promavto/Pressure_meter/DOC/ВПВ.pdf

A (2 : 1)

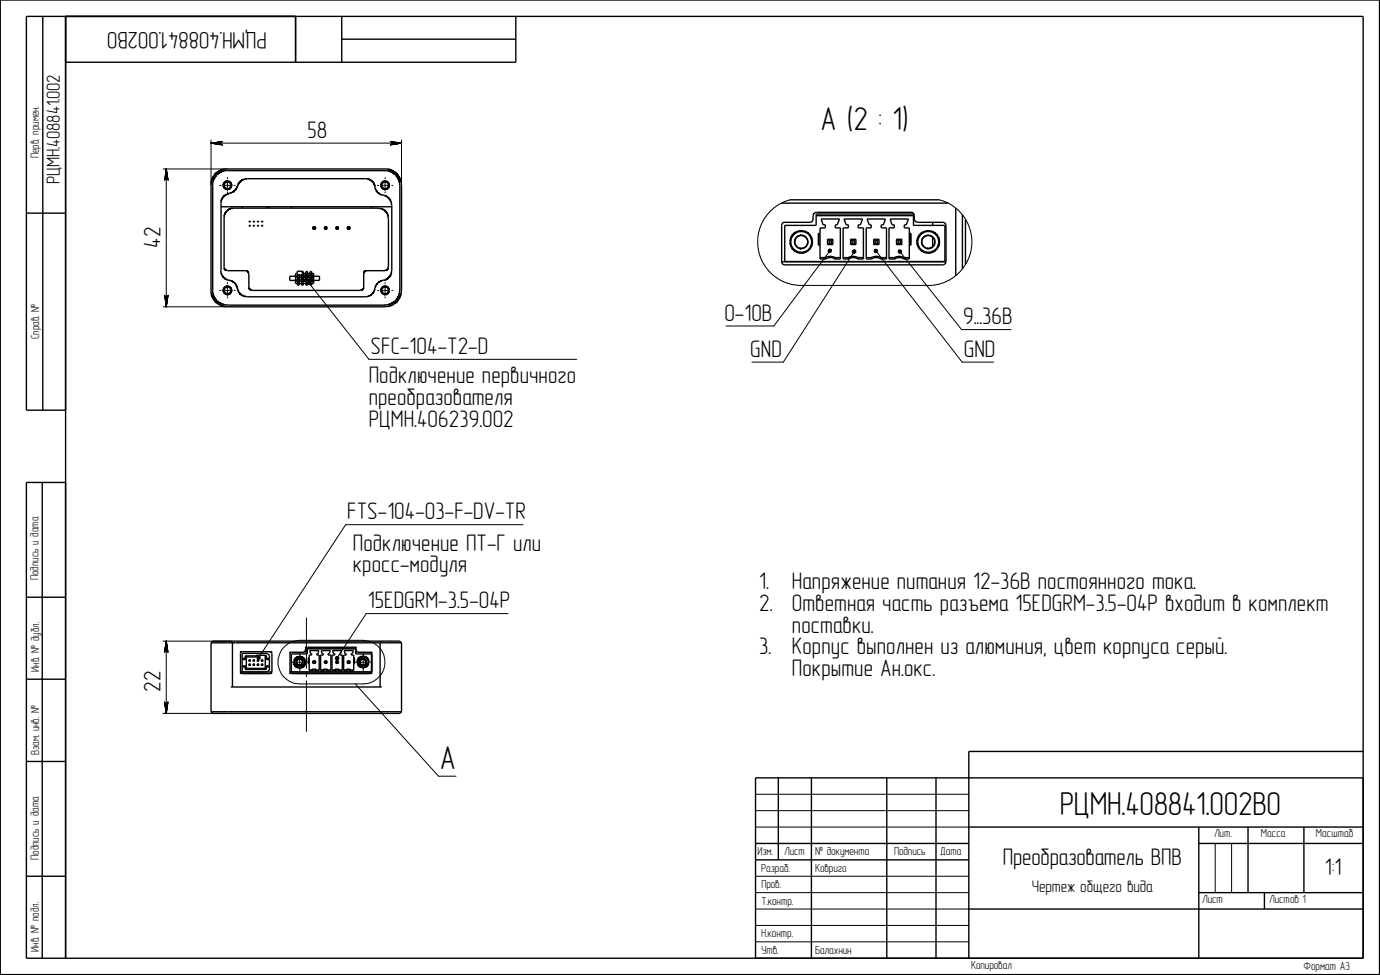
[picture p2: page 1]
ÐÖÌÍ.408841.002; Êîïèðîâàë; Ôîðìàò À3; GND; 9...36Â GND

Ñïðàâ. ¹ Ïåðâ. ïðèìåí. Ïîäïèñü è äàòà Èíâ. ¹ äóáë. Âçàì. èíâ. ¹ Ïîäïèñü è äàòà Èíâ. ¹ ïîäë. Ïðåîáðàçîâàòåëü ÂÏÂ ÐÖÌÍ.408841.002ÂÎ

SFC-104-T2-D
Ïîäêëþ÷åíèå ïåðâè÷íîãî
ïðåîáðàçîâàòåëÿ
ÐÖÌÍ.406239.002

FTS-104-03-F-DV-TR
Ïîäêëþ÷åíèå ÏÒ-Ã èëè
êðîññ-ìîäóëÿ
15EDGRM-3.5-04P

1. Íàïðÿæåíèå ïèòàíèÿ 12-36Â ïîñòîÿííîãî òîêà.
2. Îòâåòíàÿ ÷àñòü ðàçúåìà 15EDGRM-3.5-04P âõîäèò â êîìïëåêò
ïîñòàâêè.
3. Êîðïóñ âûïîëíåí èç àëþìèíèÿ, öâåò êîðïóñà ñåðûé.
Ïîêðûòèå Àí.îêñ.

×åðòåæ îáùåãî âèäà | Ëèò. | Ìàññà | Ìàñøòàá

Èçì. | Ëèñò | ¹ äîêóìåíòà | Ïîäïèñü | Äàòà | | | | | 1:1
Ðàçðàá. | | Êîâðèãî

Ïðîâ.
Ò.êîíòð. | | | | | Ëèñò | Ëèñòîâ 1

Í.êîíòð.
Óòâ. | Áàëàõíèí
