promavto/Pressure_meter/DOC/Е1.pdf

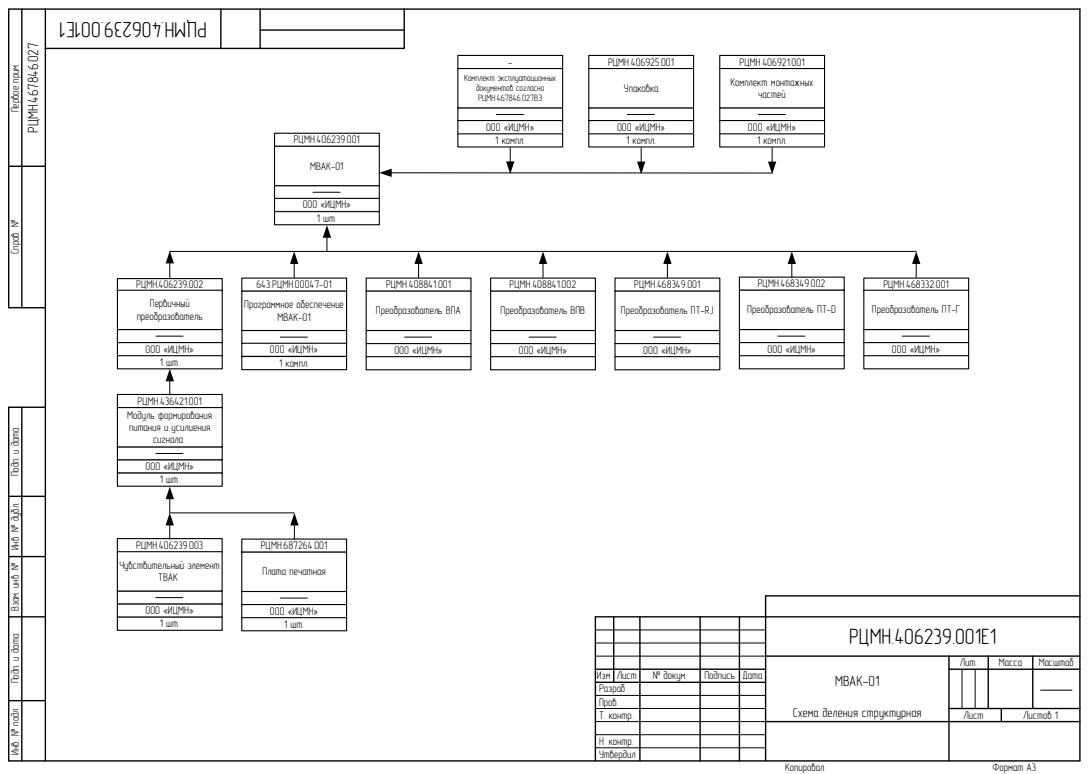
[picture p3: page 1]
Копировал; Формат А3; РЦМН.406925.001; Упаковка; ООО «ИЦМН» 1 компл.; РЦМН.406921.001; Комплект монтажных частей; 643.РЦМН.00047-01; Программное обеспечение МВАК-01; РЦМН.408841.002; Преобразователь ВПВ; ООО «ИЦМН»; РЦМН.406239.002; Первичный преобразователь; ООО «ИЦМН» 1 шт.; РЦМН.436421.001 Модуль формирования питания и усилиения сигнала; РЦМН.406239.003; Чувствительный элемент ТВАК; РЦМН.687264.001; Плата печатная; Комплект эксплуатационных документов согласно РЦМН.467846.027ВЭ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

Первое прим. Справ. № Инв. № подл. Подп. и дата Взам. инв. № Инв. № дубл. Подп. и дата

Преобразователь ПТ-RJ

РЦМН.406239.001Е1

МВАК-01 Схема деления структурная | Лит. | Масса | Масштаб

Изм. | Лист | № докум. | Подпись | Дата
Разраб.
Пров.
Т. контр. | | | | | Лист | Листов 1

Н. контр.
Утвердил
