promavto/Pressure_meter/DOC/ПТ-Г - Лист1.pdf

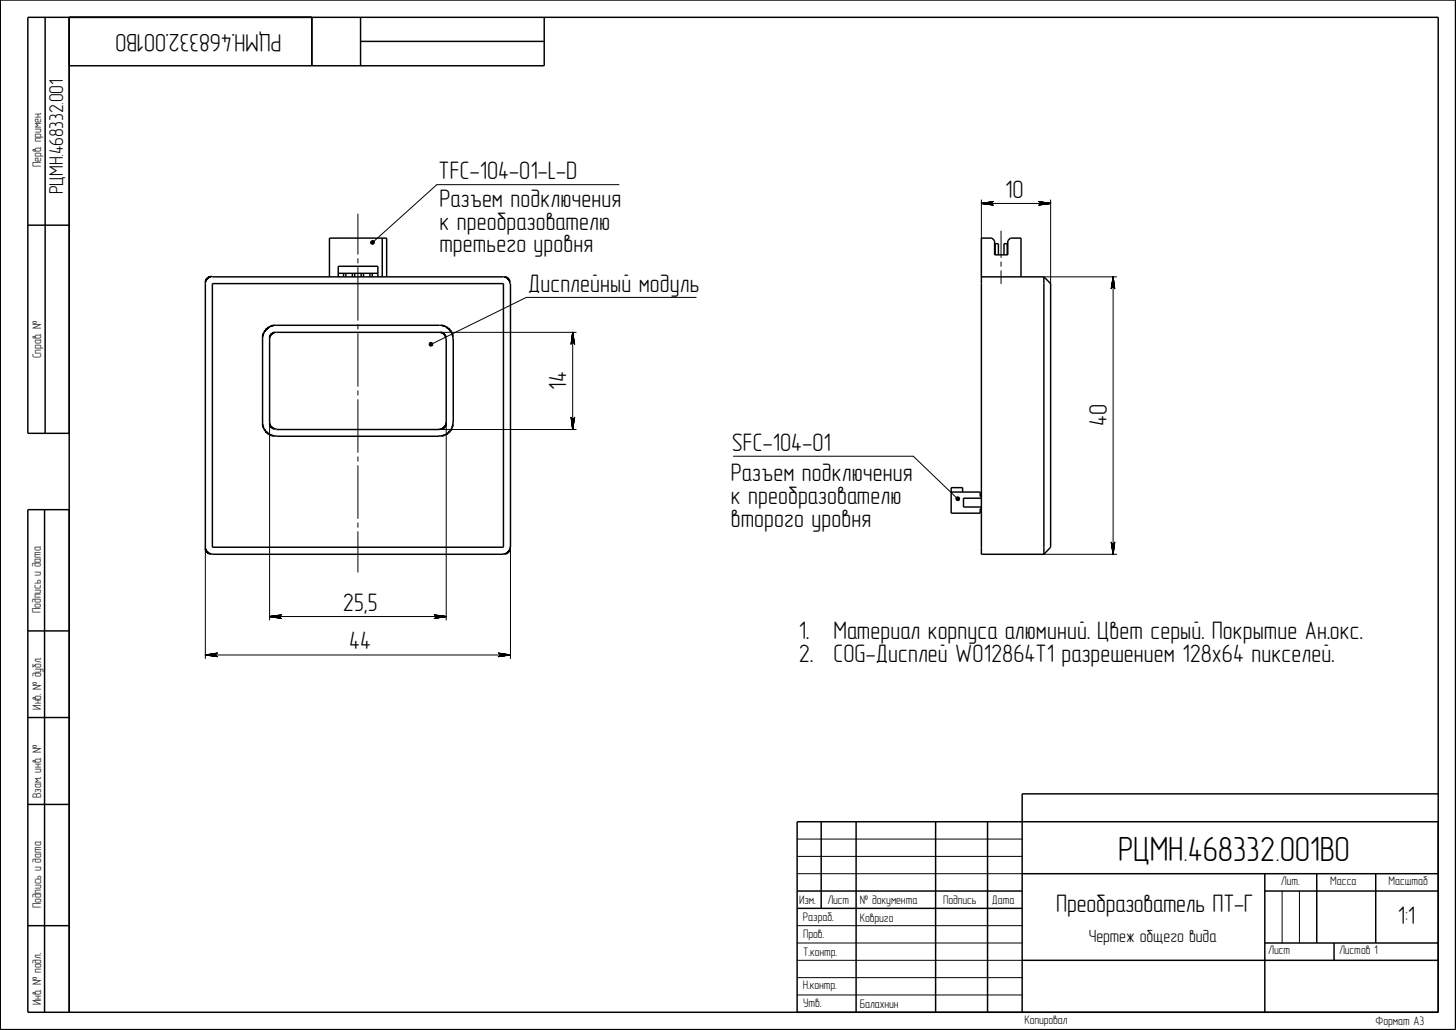
[picture p4: page 1]
ÐÖÌÍ.468332.001; Êîïèðîâàë; Ôîðìàò À3; Äèñïëåéíûé ìîäóëü

Ñïðàâ. ¹ Ïåðâ. ïðèìåí. Ïîäïèñü è äàòà Èíâ. ¹ äóáë. Âçàì. èíâ. ¹ Ïîäïèñü è äàòà Èíâ. ¹ ïîäë. Ïðåîáðàçîâàòåëü ÏÒ-Ã ×åðòåæ îáùåãî âèäà SFC-104-01 10

TFC-104-01-L-D
Ðàçúåì ïîäêëþ÷åíèÿ
ê ïðåîáðàçîâàòåëþ
òðåòüåãî óðîâíÿ

âòîðîãî óðîâíÿ

1. Ìàòåðèàë êîðïóñà àëþìèíèé. Öâåò ñåðûé. Ïîêðûòèå Àí.îêñ.
2. COG-Äèñïëåé WO12864T1 ðàçðåøåíèåì 128x64 ïèêñåëåé.

ÐÖÌÍ.468332.001ÂÎ

Ëèò. | Ìàññà | Ìàñøòàá

Èçì. | Ëèñò | ¹ äîêóìåíòà | Ïîäïèñü | Äàòà | | | | | 1:1
Ðàçðàá. | | Êîâðèãî
Ïðîâ.
Ò.êîíòð. | | | | | Ëèñò | Ëèñòîâ 1

Í.êîíòð.
Óòâ. | Áàëàõíèí
