promavto/Pressure_meter/DOC/ПТ-Г.pdf

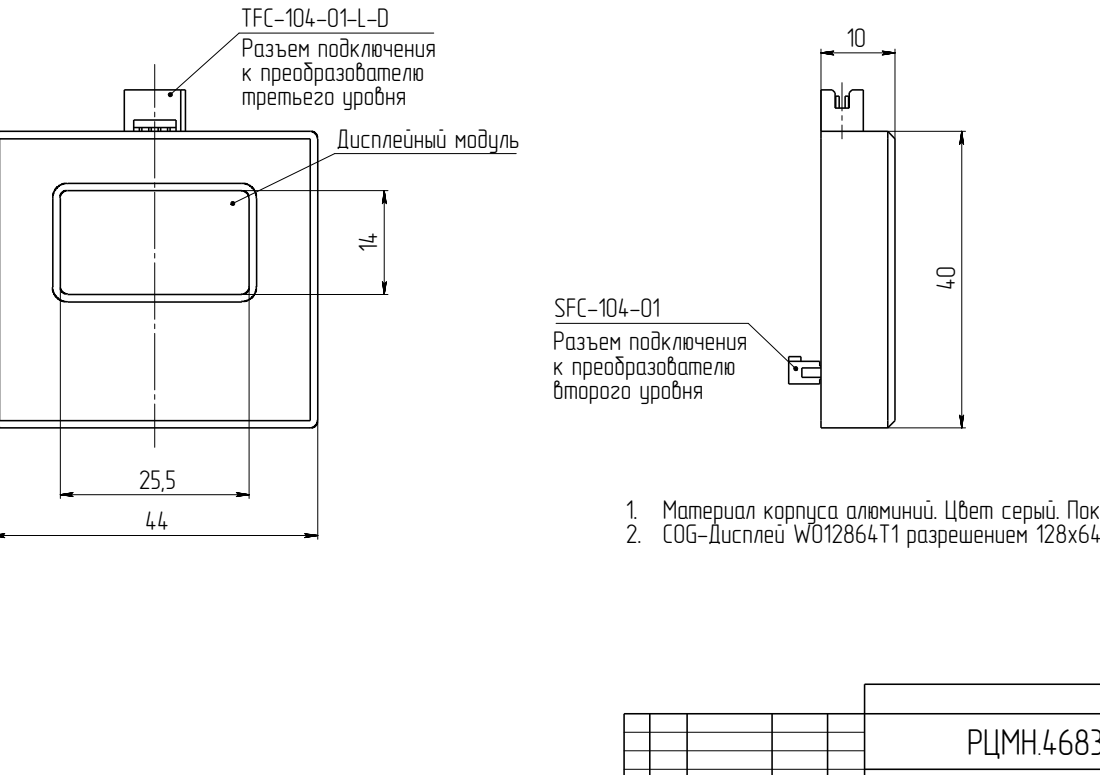
[picture p5: page 1]
ÐÖÌÍ.468332.001ÂÎ; Äèñïëåéíûé ìîäóëü

TFC-104-01-L-D
Ðàçúåì ïîäêëþ÷åíèÿ
ê ïðåîáðàçîâàòåëþ
òðåòüåãî óðîâíÿ

SFC-104-01
âòîðîãî óðîâíÿ

1. Ìàòåðèàë êîðïóñà àëþìèíèé. Öâåò ñåðûé. Ïîêðûòèå Àí.
2. COG-Äèñïëåé WO12864T1 ðàçðåøåíèåì 128x64 ïèêñåëåé.
