promavto/Pressure_meter/DOC/Сборка вакуумметра - Лист1.pdf

A

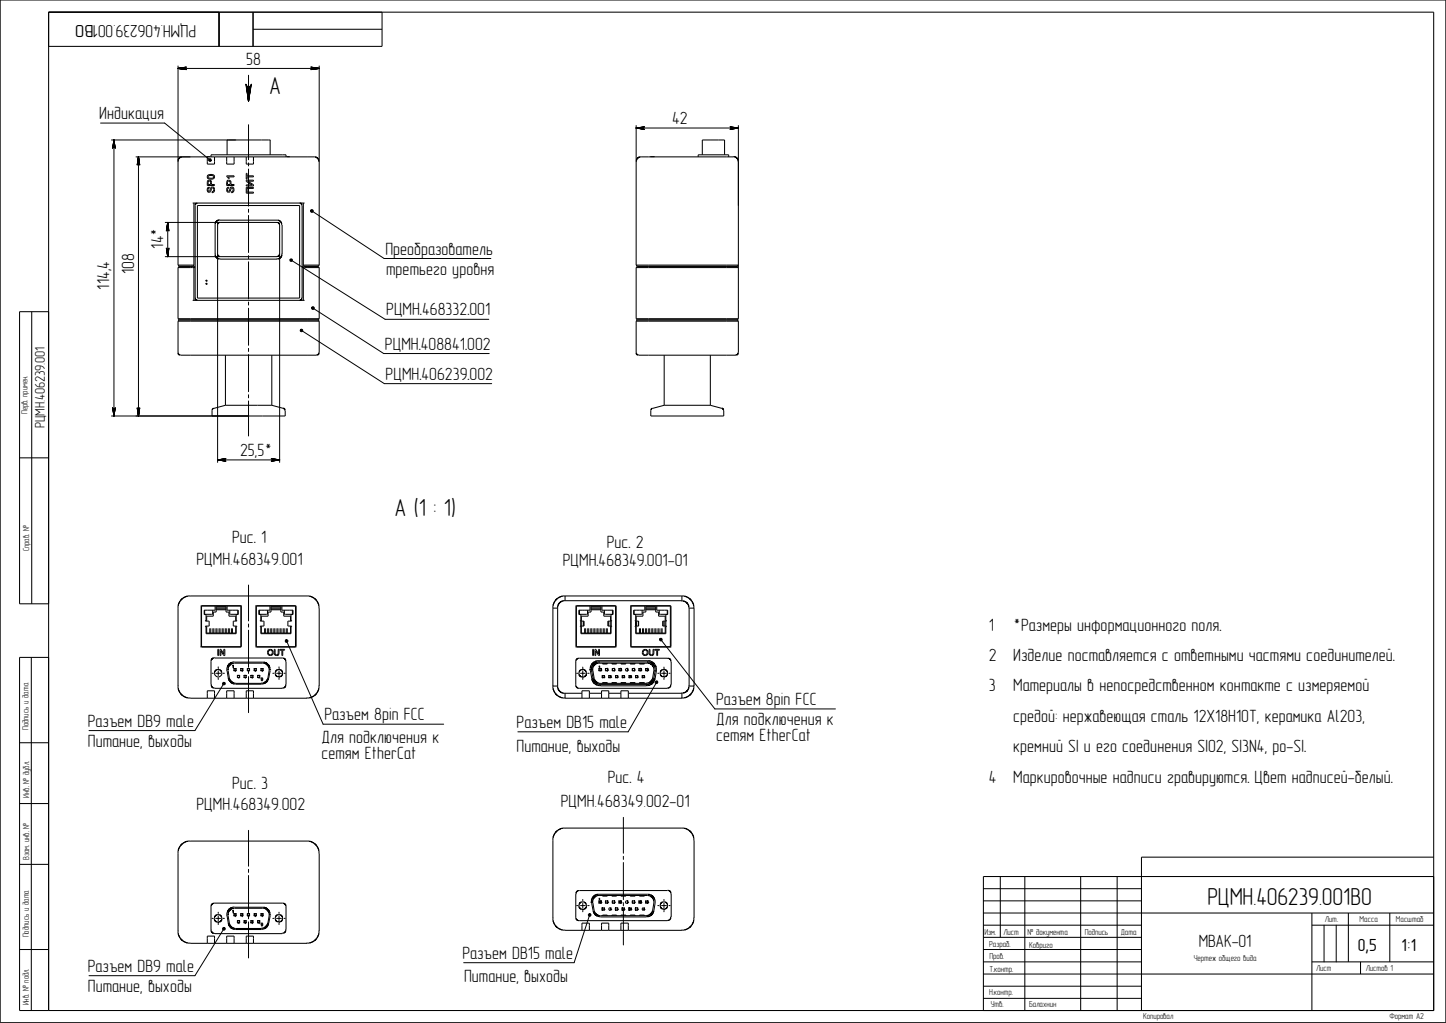
[picture p6: page 1]
Èíâ. ¹ ïîäë.; Êîïèðîâàë; Ôîðìàò À2; ÐÖÌÍ.406239.001; Ðèñ. 1; Ðàçúåì DB9 male; ÐÖÌÍ.468349.001; Ïðåîáðàçîâàòåëü; ÐÖÌÍ.468332.001; ÐÖÌÍ.406239.002; ÐÖÌÍ.408841.002; Èíäèêàöèÿ; òðåòüåãî óðîâíÿ; Ïèòàíèå, âûõîäû; Ðèñ. 4; Ðàçúåì DB15 male; ÐÖÌÍ.468349.002-01; Ðèñ. 2; ÐÖÌÍ.468349.001-01; Ðèñ. 3; ÐÖÌÍ.468349.002

Ñïðàâ. ¹ Ïåðâ. ïðèìåí. Ïîäïèñü è äàòà Èíâ. ¹ äóáë. Âçàì. èíâ. ¹ Ïîäïèñü è äàòà ÌÂÀÊ-01

1 *Ðàçìåðû èíôîðìàöèîííîãî ïîëÿ.
2 Èçäåëèå ïîñòàâëÿåòñÿ ñ îòâåòíûìè ÷àñòÿìè ñîåäèíèòåëåé.
3 Ìàòåðèàëû â íåïîñðåäñòâåííîì êîíòàêòå ñ èçìåðÿåìîé
ñðåäîé: íåðæàâåþùàÿ ñòàëü 12Õ18Í10Ò, êåðàìèêà Al2O3,
êðåìíèé SI è åãî ñîåäèíåíèÿ SIO2, SI3N4, po-SI.
4 Ìàðêèðîâî÷íûå íàäïèñè ãðàâèðóþòñÿ. Öâåò íàäïèñåé-áåëûé.

Ðàçúåì 8pin FCC
Äëÿ ïîäêëþ÷åíèÿ ê
ñåòÿì EtherCat

ÂÎ ÐÖÌÍ.406239.001

×åðòåæ îáùåãî âèäà | Ëèò. | Ìàññà | Ìàñøòàá

Èçì. | Ëèñò | ¹ äîêóìåíòà | Ïîäïèñü | Äàòà | | | | | 0,5 | 1:1
Ðàçðàá. | | Êîâðèãî
Ïðîâ.
Ò.êîíòð. | | | | | Ëèñò | Ëèñòîâ 1

Ðàçúåì DB9 male
Ïèòàíèå, âûõîäû

Í.êîíòð.
Óòâ. | Áàëàõíèí
