promavto/Pressure_meter/DOC/Сборка пп - Лист1.pdf

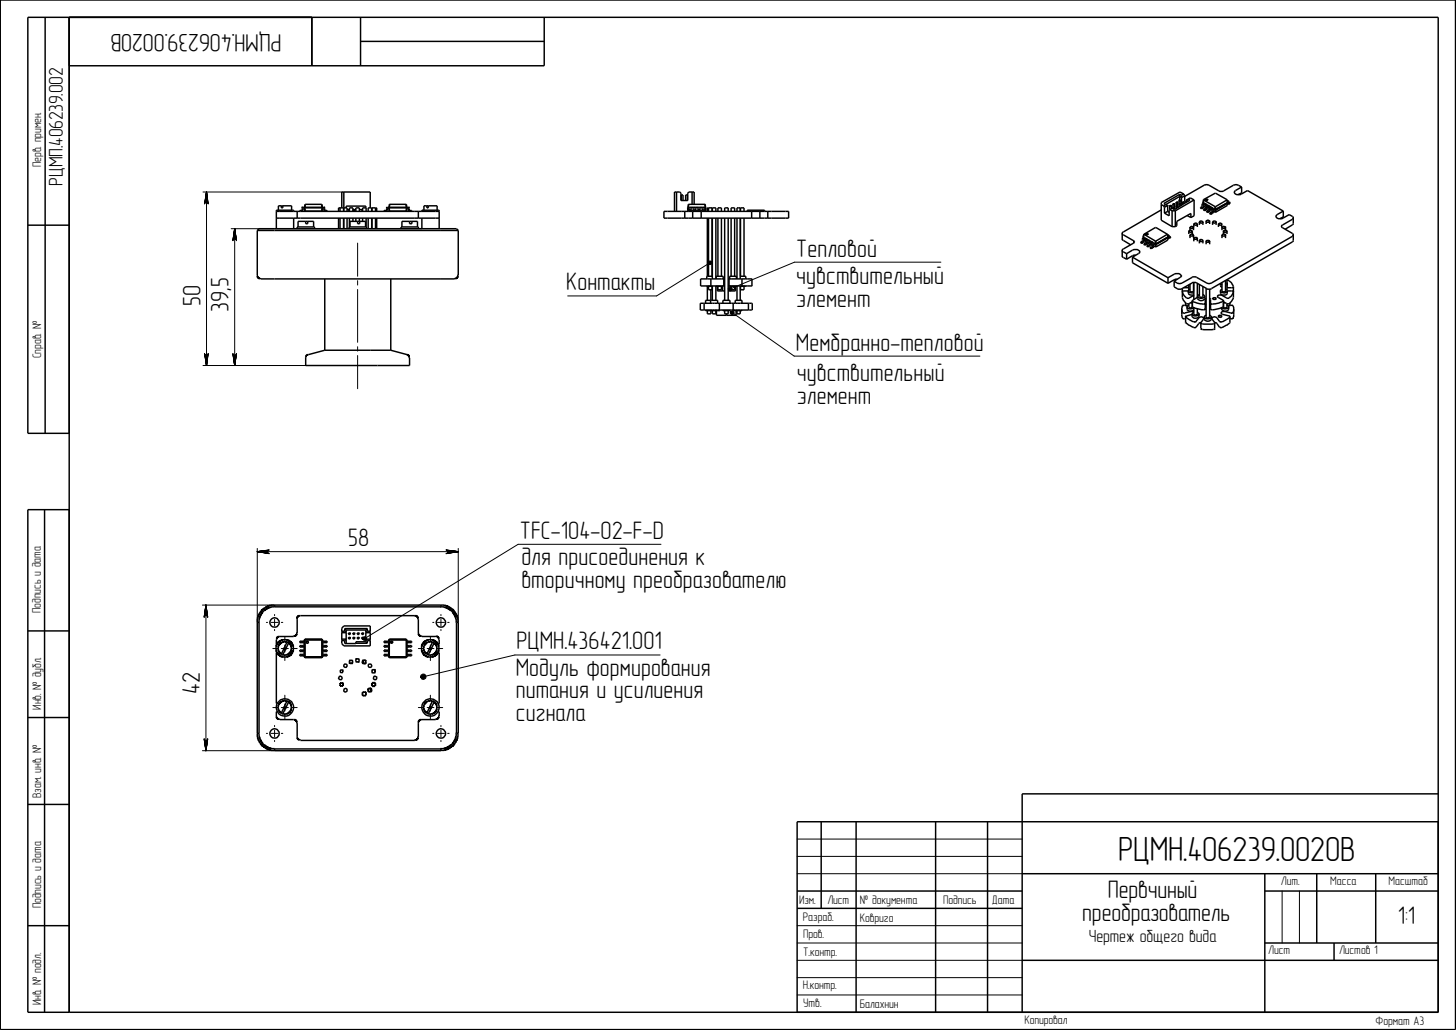
[picture p7: page 1]
ÐÖÌÏ.406239.002; Êîïèðîâàë; Ôîðìàò À3; ÐÖÌÍ.436421.001 Ìîäóëü ôîðìèðîâàíèÿ ïèòàíèÿ è óñèëèåíèÿ ñèãíàëà; TFC-104-02-F-D 58; Ìåìáðàííî-òåïëîâîé; Òåïëîâîé; ýëåìåíò; ÷óâñòâèòåëüíûé Êîíòàêòû; ÷óâñòâèòåëüíûé ýëåìåíò

Ñïðàâ. ¹ Ïåðâ. ïðèìåí. Ïîäïèñü è äàòà Èíâ. ¹ äóáë. Âçàì. èíâ. ¹

äëÿ ïðèñîåäèíåíèÿ ê
âòîðè÷íîìó ïðåîáðàçîâàòåëþ

Ïîäïèñü è äàòà Èíâ. ¹ ïîäë. ïðåîáðàçîâàòåëü ÐÖÌÍ.406239.002ÎÂ Ïåðâ÷èíûé ×åðòåæ îáùåãî âèäà

Ëèò. | Ìàññà | Ìàñøòàá

Èçì. | Ëèñò | ¹ äîêóìåíòà | Ïîäïèñü | Äàòà | | | | | 1:1
Ðàçðàá. | | Êîâðèãî

Ïðîâ.
Ò.êîíòð. | | | | | Ëèñò | Ëèñòîâ 1

Í.êîíòð.
Óòâ. | Áàëàõíèí
