promavto/Pressure_meter/(list of files, drawings)

Other design files:
Pascal/PaAnalyzer_2023_12_27_WEB_01/DOC/Gas_analyzerESP32_03R.pdsprj
Pascal/PaAnalyzer_2023_12_27_WEB_02/DOC/Gas_analyzerESP32_03R.pdsprj
Proteus/Gas_analyzerESP32_07_1.pdsprj
Proteus/Pa_analyzerESP32_01.pdsprj
Proteus/Pa_analyzerSTM32F103_01.pdsprj
Proteus/Project Backups/UROV_STM32F407_167_02 [Proteus 8.11].pdsprj
Proteus/UROV_STM32F407_167_02.pdsprj
