promavto/Pressure_meter/Pascal/DOC/ADS1110-master/extras/eagle/ADS1110.brd

## EAGLE design Pascal/DOC/ADS1110-master/extras/eagle/ADS1110.brd (2024-01-09)

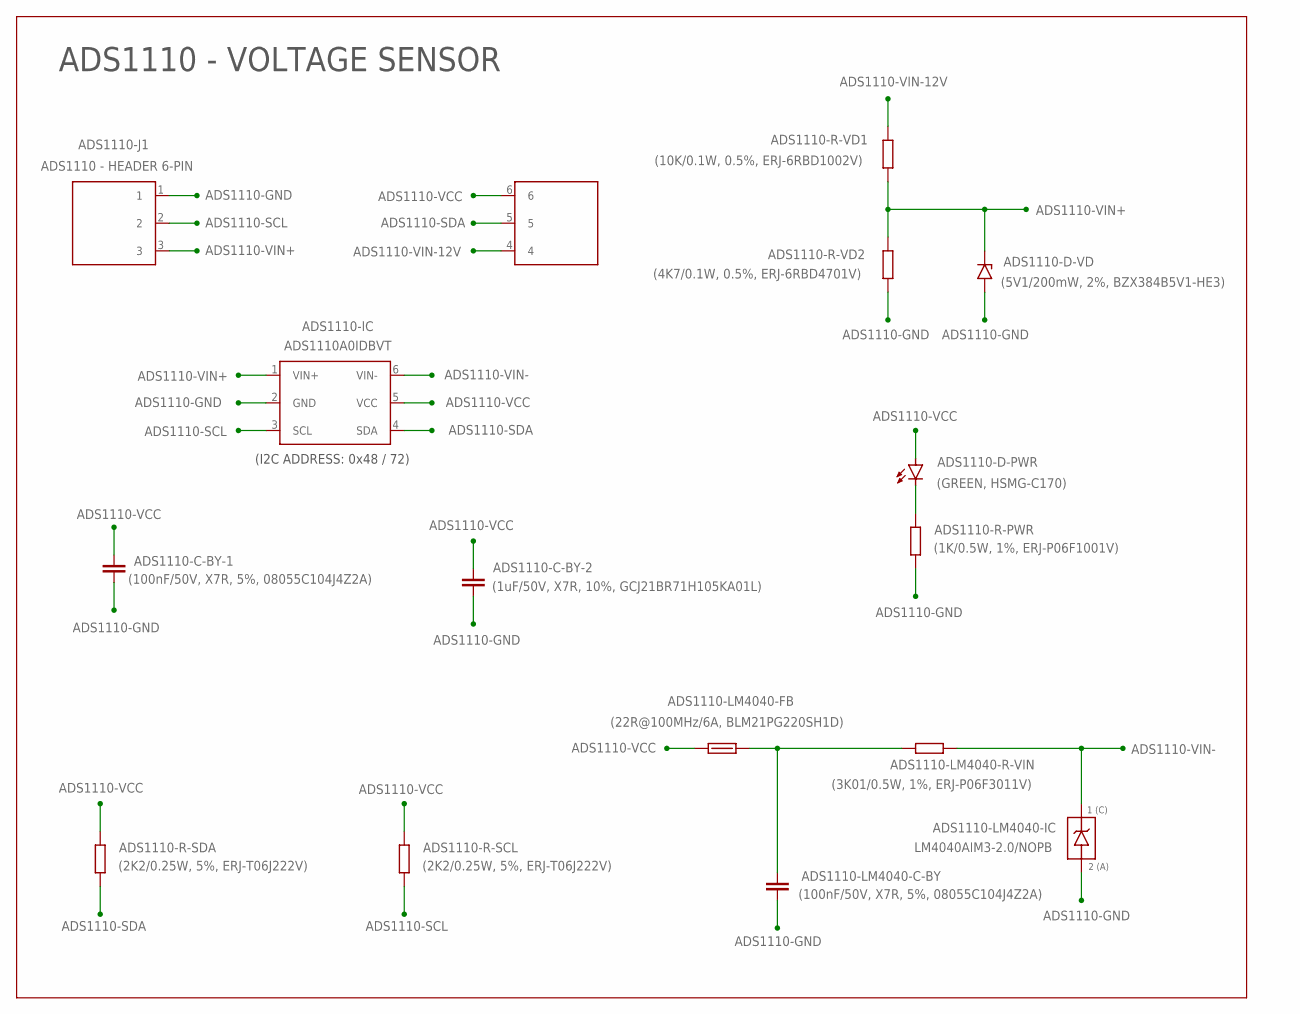
[picture p8: schematic ADS1110.sch]

Parts:
ADS1110-C-BY-1, ADS1110-LM4040-C-BY: (100nF/50V, X7R, 5%, 08055C104J4Z2A); 0805
ADS1110-C-BY-2: (1uF/50V, X7R, 10%, GCJ21BR71H105KA01L); 0805
ADS1110-D-PWR: (GREEN, HSMG-C170); DIODE_0805
ADS1110-D-VD: (5V1/200mW, 2%, BZX384B5V1-HE3); SOD-323-DIODE
ADS1110-IC: ADS1110A0IDBVT; SOT-457-6
ADS1110-J1: ADS1110 - HEADER 6-PIN; HEADER_2.54MM_6_PIN_VER
ADS1110-LM4040-FB: (22R@100MHz/6A, BLM21PG220SH1D); 0805
ADS1110-LM4040-IC: LM4040AIM3-2.0/NOPB; SOT-23-3
ADS1110-LM4040-R-VIN: (3K01/0.5W, 1%, ERJ-P06F3011V); 0805
ADS1110-R-PWR: (1K/0.5W, 1%, ERJ-P06F1001V); 0805
ADS1110-R-SCL, ADS1110-R-SDA: (2K2/0.25W, 5%, ERJ-T06J222V); 0805
ADS1110-R-VD1: (10K/0.1W, 0.5%, ERJ-6RBD1002V); 0805
ADS1110-R-VD2: (4K7/0.1W, 0.5%, ERJ-6RBD4701V); 0805

Connections:
ADS1110-GND: ADS1110-C-BY-1.2 (C), ADS1110-C-BY-2.1 (A), ADS1110-D-VD.A, ADS1110-IC.2 (GND), ADS1110-J1.1, ADS1110-LM4040-C-BY.2 (C), ADS1110-LM4040-IC.2 (A), ADS1110-LM4040-IC.3 (A), ADS1110-R-PWR.1, ADS1110-R-VD2.2
ADS1110-LED-PWR: ADS1110-D-PWR.C, ADS1110-R-PWR.2
ADS1110-SCL: ADS1110-IC.3 (SCL), ADS1110-J1.2, ADS1110-R-SCL.1
ADS1110-SDA: ADS1110-IC.4 (SDA), ADS1110-J1.5, ADS1110-R-SDA.1
ADS1110-VCC: ADS1110-C-BY-1.1 (A), ADS1110-C-BY-2.2 (C), ADS1110-D-PWR.A, ADS1110-IC.5 (VCC), ADS1110-J1.6, ADS1110-LM4040-FB.2, ADS1110-R-SCL.2, ADS1110-R-SDA.2
ADS1110-VCC-FILTERED: ADS1110-LM4040-C-BY.1 (A), ADS1110-LM4040-FB.1, ADS1110-LM4040-R-VIN.2
ADS1110-VIN+: ADS1110-D-VD.C, ADS1110-IC.1 (VIN+), ADS1110-J1.3, ADS1110-R-VD1.2, ADS1110-R-VD2.1
ADS1110-VIN-: ADS1110-IC.6 (VIN-), ADS1110-LM4040-IC.1 (C), ADS1110-LM4040-R-VIN.1
ADS1110-VIN-12V: ADS1110-J1.4, ADS1110-R-VD1.1

Notes on the sheet:
(I2C ADDRESS: 0x48 / 72)
ADS1110 - VOLTAGE SENSOR

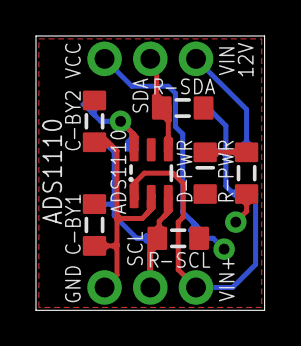
[picture p9: board ADS1110.brd from above]

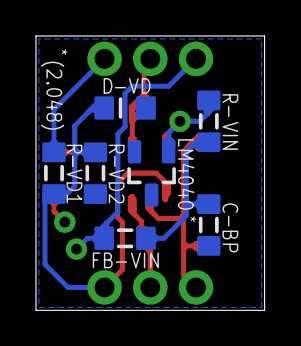
[picture p10: board ADS1110.brd from below]

Board: 2 copper layers, 12.7 x 15.2 mm, 15 parts (7 on the bottom side), 9 nets.
